c-/bunGrbl-Breakout/bunGrbl-Breakout.kicad_pcb

## KiCad design bunGrbl-Breakout.kicad_pcb (2022-12-09)

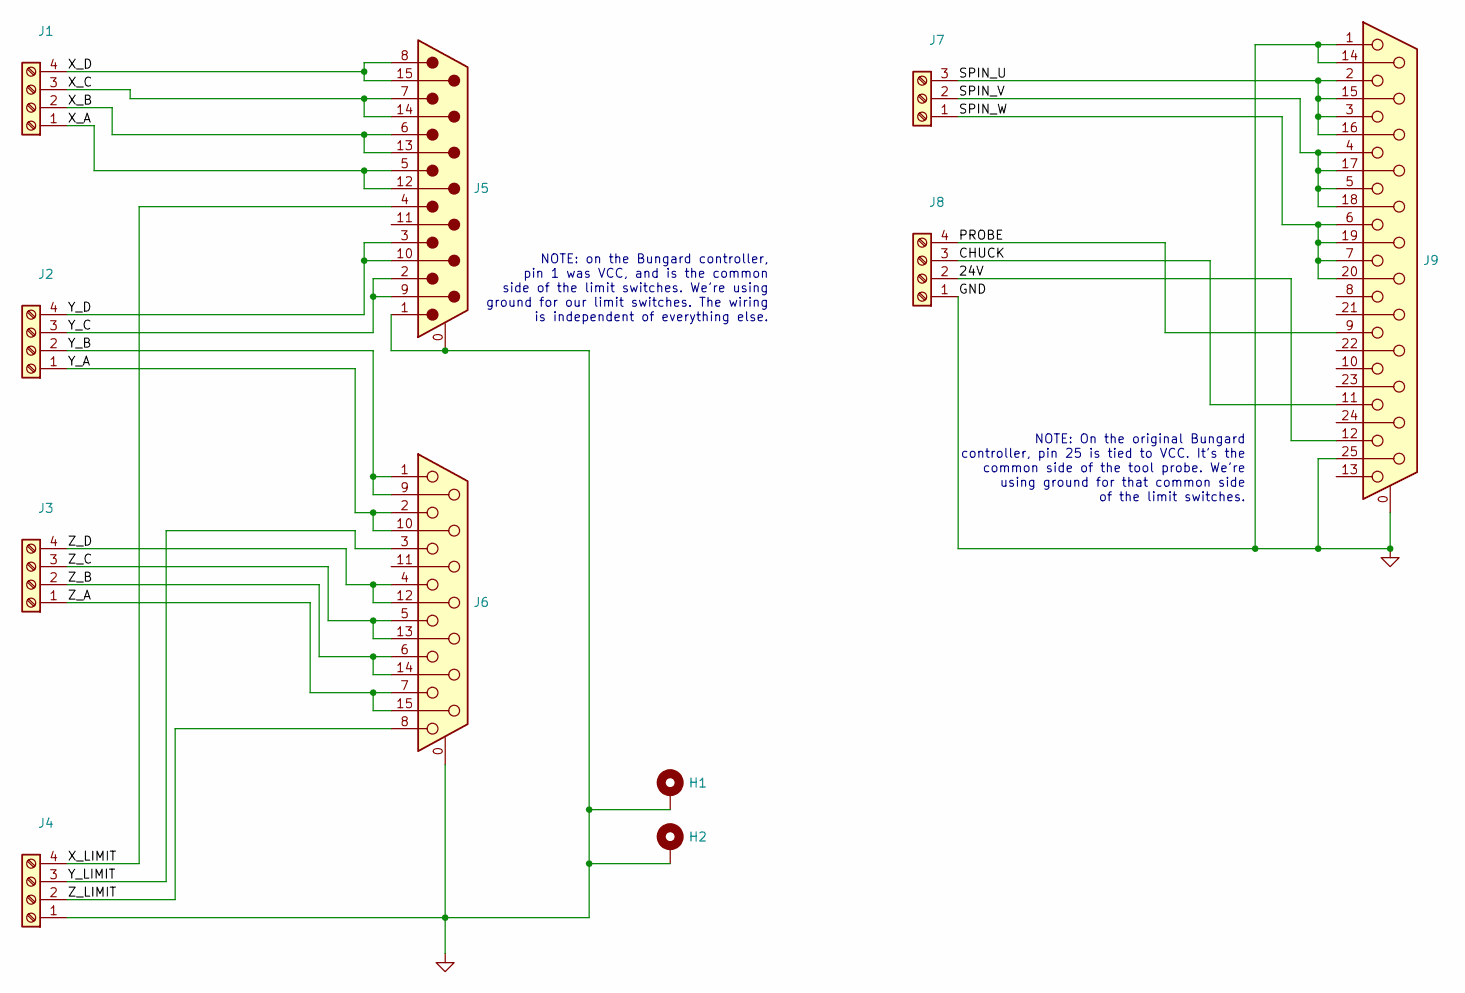
[picture p3: schematic bunGrbl-Breakout.kicad_sch]

Parts:
H1, H2: MountingHole_5.3mm_M5_Pad
J1, J2, J3, J4, J8: TerminalBlock_MetzConnect_Type086_RT03404HBLC_1x04_P3.81mm_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
J5: DSUB-15_Male_Horizontal_FatPin_P2.77x2.84mm_EdgePinOffset7.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
J6: DSUB-15_Female_Horizontal_FatPin_P2.77x2.84mm_EdgePinOffset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
J7: TerminalBlock_Phoenix_MKDS-3-3-5.08_1x03_P5.08mm_Horizontal
J9: DSUB-25_Female_Horizontal_FatPad_P2.77x2.84mm_EdgePinOffset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

Connections:
/24V: J8.2, J9.12
/CHUCK: J8.3, J9.11
/PROBE: J8.4, J9.9
/SPIN_U: J7.3, J9.2, J9.3, J9.15, J9.16
/SPIN_V: J7.2, J9.4, J9.5, J9.17, J9.18
/SPIN_W: J7.1, J9.6, J9.7, J9.19, J9.20
/X_A: J1.1, J5.5, J5.12
/X_B: J1.2, J5.6, J5.13
/X_C: J1.3, J5.7, J5.14
/X_D: J1.4, J5.8, J5.15
/X_LIMIT: J4.4, J5.4
/Y_A: J2.1, J6.2, J6.10
/Y_B: J2.2, J6.1, J6.9
/Y_C: J2.3, J5.2, J5.9
/Y_D: J2.4, J5.3, J5.10
/Y_LIMIT: J4.3, J6.3
/Z_A: J3.1, J6.7, J6.15
/Z_B: J3.2, J6.6, J6.14
/Z_C: J3.3, J6.5, J6.13
/Z_D: J3.4, J6.4, J6.12
/Z_LIMIT: J4.2, J6.8
GND: H1.1, H2.1, J4.1, J5.0 (PAD), J5.1, J6.0 (PAD), J8.1, J9.0 (PAD), J9.1, J9.14, J9.25

Notes on the sheet:
NOTE: On the original Bungard controller, pin 25 is tied to VCC. It's the common side of the tool probe. We're using ground for that common side of the limit switches.
NOTE: on the Bungard controller, pin 1 was VCC, and is the common side of the limit switches. We're using ground for our limit switches. The wiring is independent of everything else.

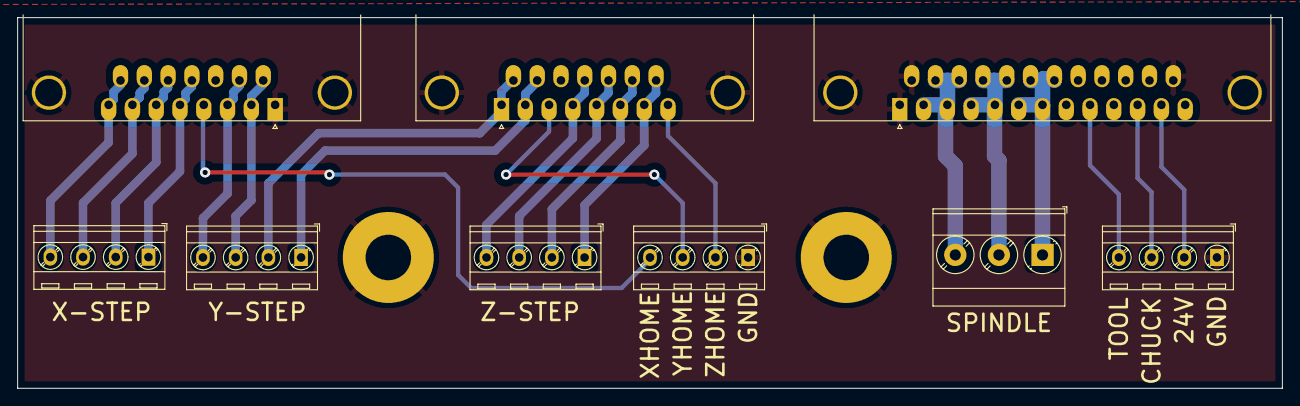
[picture p4: board bunGrbl-Breakout.kicad_pcb from above]

Board: 2 copper layers, 147.3 x 43.2 mm, 11 parts (0 on the bottom side), 22 nets.
